t-lefeld/ONU-baja-daq/can/README.md

# CAN Bus

## Topology

- **Baud rate:** 500kbps
- **Physical layer:** Ethernet CAT5e twisted pair (differential pair used as CAN H/L)
- **Connectors:** Deutsch DT series throughout
- **Termination:** 120Ω at each end of the bus (firewall node and farthest corner node)

## Node IDs

| Node | CAN ID (base) | Location |
|---|---|---|
| Front | 0x010 | Toebox, frame-mounted |
| Rear | 0x020 | By the gas tank, frame-mounted |
| eCVT | 0x030 (reserved, unconfirmed) | CVT assembly |
| Firewall | 0x000 | Firewall — aggregator, **and carries GPS, IMU, LoRa and SD** |
| Display | not yet assigned | Driver-facing; listens only, never transmits |

The firewall is not sensorless: it reads GPS and a 9-DOF IMU directly. See
`nodes/firewall/README.md`.

eCVT is an ODrive S1 assembly rather than a custom sensor node (see
`nodes/ecvt/README.md`). It sits on this bus, but the DAQ side is paused
until next year. The ODrive addresses messages as
`(axis_node_id << 5) | cmd_id`, which collides with the DAQ's own block
unless the ODrive stays below node id 16 — see `protocol/V2_DESIGN_NOTES.md`.

## DBC File

**There is no `baja.dbc` in this folder.** Earlier revisions of this file
told you to load one; it does not exist. The real CAN databases are:

| File | Status |
|---|---|
| `protocol/telemetry.dbc` | **v1 — the wire format running today.** Generated by `tools/gen_dbc.py`, not hand-edited. |
| `protocol/telemetry_v2.dbc` | v2 scaffold — not on the wire yet. |

```python
import cantools
db = cantools.database.load_file('protocol/telemetry.dbc')
```

Treat the topology and wiring notes in this file as current, but take the
wire format itself from `protocol/`.

## Wiring Notes

- Ethernet twisted pair used for CAN H/L — do not use solid-core wire
- Deutsch DT connectors: pin A = CAN H, pin B = CAN L, pin C = GND reference
- Keep stub lengths short at each node tap — max 30cm recommended
- Shield drain wire tied to chassis GND at firewall end only (single-point ground)

## Reliability Features

- Sequence numbering on all messages — detect dropped frames at the dashboard
- Watchdog timer on each node — CAN TX halted and error frame sent if node hangs
- SD log on firewall captures raw CAN frames as backup regardless of LoRa link status
