t-lefeld/ONU-baja-daq/HANDOFF.md

# Handoff — read this first

Written 2026-08-12, updated 2026-08-23 for whoever (or whatever) picks this
up next. Assume no memory of prior conversations. This file is the
orientation; the other docs are the detail.

---

## What this is

A telemetry system for a **Baja SAE** competition vehicle, built by one
student (Tate, Ohio Northern University). Sensors on the car → CAN bus →
a hub board → 900 MHz LoRa radio → laptop in the pits, with an SD card on the
hub as a black box in case the radio drops.

**Hardware, all physically in hand and working:**

- 3× STM32F103C8 "Blue Pill" — CAN sensor nodes
- 1× STM32L476RG Nucleo — hub (aggregates CAN, drives radio + SD)
- 2× Ebyte E22-900T22 LoRa modules — one `-D` (DIP, on the hub), one `-U`
  (USB dongle, on the laptop). **Both configured to channel `0x45`
  (decimal 69) = 919.125 MHz.** Config mode: DIP module needs M1=HIGH/M0=LOW
  wiring; the USB dongle has a side button (hold ~2 s, LED goes solid red).
- microSD module on the hub over SPI
- Programming: a Black Magic Probe (a Black Pill flashed with BMP firmware)
  for the Bluepills over PlatformIO; the Nucleo uses its own onboard ST-Link.

**Planned but not yet wired:** HGLRC Mini M100 GPS, BNO080 IMU, 3× Littelfuse
55505-00-02-A-ND gear tooth sensors (two front wheels, one on the rear brake
disc), 4× AS5600 suspension encoders on bellcranks (one per corner, run in
analog-output mode), Anfield T200/T201 brake pressure, MLX90614 temperature,
ODrive S1 motor controller.

Part numbers above were corrected on 2026-10-30. Older docs may still say
NEO-M8N, Littelfuse 55075, or Bourns 53AAA pots — those are superseded. Note
the driver files `gps_neo_m8n.*` and `suspension_pot.*` keep their old names;
see `firmware/sensors/README.md` for why that's harmless.

---

## The single most important thing to understand

**There are three versions now: v1, v2, v3. v2 is fully bench-verified on
real hardware as of 2026-08-16 — end-to-end data flow, SD logging, and fault
recovery (node drop/reconnect, full bus drop/reconnect) all confirmed working.
v3 (real sensors) is in progress as of 2026-08-16 — CubeMX pin-out is done for
all three boards (Front, Rear, Hub), but no sensor driver has been wired into
`can_node_v2.c`/`telemetry_hub_v2.c` yet, and none of it has been physically
verified against real sensors. See `V3_BRINGUP_CHECKLIST.md` for exact status
per sensor.**

| | v1 | v2 | v3 |
|---|---|---|---|
| Status | **Working on real hardware**, verified end to end | **Fully bench-verified on real hardware** — live data, SD logging, fault recovery all confirmed | **In progress** — CubeMX pin-out done on all 3 boards; drivers not wired in, nothing physically verified yet |
| Channels | 9 placeholder | 24, but still **simulated in firmware**, not from real sensors | 24, real sensor reads (once driver wiring + verification catches up to the pin-out) |
| Nodes | 3 (all Bluepills) | 4 (Hub, Front, Rear, Motor — see board mapping below) | same as v2 |
| Frame | 42 bytes @ 2 Hz | 80 bytes @ 2 Hz | 80 bytes @ 2 Hz |
| What's flashed where | All 3 Bluepills + Hub | **2nd Bluepill = Front, 3rd Bluepill = Rear, Hub = Nucleo, 1st Bluepill = temporary Motor/E-CVT stand-in for the bench test.** | same boards as v2, minus the stand-in once the real ODrive replaces it |

**v3 CubeMX pin-out, done 2026-08-16 (see `V3_CUBEMX_AND_SENSOR_INTEGRATION_GUIDE.md`
for the canonical pinout and `V3_BRINGUP_CHECKLIST.md` for the per-sensor
checklist):** Front (2nd Bluepill) has wheel encoders on PA0/PA1 (EXTI,
falling edge, pull-up), suspension pots on PA4/PA5 (ADC1), and both brake
pressure transducers on PA6/PA7 (ADC1). Rear (3rd Bluepill) has the same
encoder/suspension pins plus the CVT thermistor on I2C1 PB6/PB7 — **this
assumes the PCB trace fix from PB8 to PB6 has actually been done; CubeMX
config and physical board traces are independent, so double check before
trusting this pin config.** Hub (Nucleo) has GPS on USART3 PC4/PC5 (9600
baud, RX interrupt) and the IMU on I2C1 PB8/PB9 + INT on PB1 (EXTI, falling
edge, pull-up) + RST on PB2 (GPIO output) — **these Hub pins are still
suggestions, no PCB has been shared for that board.** All three Bluepills'
ADC clocks were fixed to a valid 12MHz (PLLMUL stays X9 for 72MHz system
clock, ADC Prescaler set to /6 — never use CubeMX's "Resolve Clock Issues"
auto-solver here, it drops the whole system clock to fix the ADC alone, see
the mistake below). All 15 test suites pass after each board's regeneration.

**Board mapping for v2 (this was an open decision as of 08-12, settled 08-13,
then extended 08-14):** in the *final* design, node 0 (Hub/GPS/IMU) and node 3
(E-CVT/Motor) have no physical Bluepill — the hub originates both directly
(real GPS/IMU/ODrive in v3). Only Front and Rear are permanent Bluepill
roles.

**Temporary addition, 2026-08-14 — a 4th "board" for the v2 bench test only:**
the 1st Bluepill (previously the idle spare) is flashed with `node_id.h` set
to `NODE_ID 3` and now transmits real `tlm2_can_pack_pages()` bursts for the
Motor node, so the hub's reassembler gets exercised by an actual 4th CAN
transmitter instead of leaving node 3 hub-internal during the test. This is
**not** what node 3 looks like in the real system — the ODrive doesn't speak
this protocol at all, it speaks CAN Simple, addressed by `axis_node_id`, not
`TLM2_CAN_ID_FOR(3, page)`. Swapping in the real ODrive later means removing
this stand-in board from the bus entirely, not reflashing it to "the real
thing" — see `can_node_v2.h`'s header comment for the full reasoning. The
hub-side switch is `HUB2_SIMULATE_NODE3` in `telemetry_hub_v2.h`, set to `0`
via a compiler `-D` flag (both `platformio.ini`'s `build_flags` and the
CubeIDE `.cproject`'s preprocessor symbols — **not** a `#define` in `main.c`,
see the "translation unit" mistake below) right now specifically because this
stand-in is on the bus — **if you ever pull this board off the bus without
also flipping that back to `1` (or removing the `-D`), node 3 goes
stale/nothing shows up, not "back to simulated."** The 1st Bluepill is not a
working v1 fallback spare while wearing this hat — see the note in its
`node_id.h`.

**Two separate build systems, two separate exclusion lists — this bit us
2026-08-14.** Every project has both a CubeIDE `.cproject` and a
`platformio.ini`, and PlatformIO does **not** read `.cproject` at all — it
has its own `build_src_filter` that compiles everything under `Core/Src/` on
its own. Excluding a stale v1 file from one build system does nothing for
the other. Two exclusions were needed and are now both in place: the
Nucleo's `telemetry_hub.c` (duplicate `HAL_CAN_RxFifo0MsgPendingCallback` at
link time) and the 1st Bluepill's `can_node.c` (v1's `can_node.h` hard-errors
at compile time for `NODE_ID 3`, which is outside v1's valid 0-2 range, even
though nothing calls into that file). `tools/test_repo.py` now checks both
`platformio.ini` files for these exclusions specifically so this can't drift
back silently. **None of this has been compile-verified against the real ARM
toolchain from this end** — there's no `arm-none-eabi-gcc`/PlatformIO
available in the environment doing this work, only the host-side C tests
(hal_shim-mocked, not real HAL). The PlatformIO build output is the first
real compile check any of this has had — keep pasting errors if more show up.

**What "v2 wired in" actually means right now:** `can_node_v2.c`/`.h` and
`telemetry_hub_v2.c`/`.h` (all pre-existing, host-tested library code) are now
copied into the 2nd Bluepill, 3rd Bluepill, and Nucleo hub CubeIDE projects,
and each project's `main.c` calls the v2 init/task functions instead of v1's.
`telemetry_hub.c` is excluded from the hub project's build (both files define
a strong `HAL_CAN_RxFifo0MsgPendingCallback`, so linking both is a link
error). **None of this has been flashed to hardware or bench-tested yet** —
that's the next real milestone, and per the "verify, don't assert" rule nothing
above should be taken as proof it works until it's been run.

v1 files are untouched throughout — `protocol/telemetry_proto.{h,c}`,
`can_node.c`, `telemetry_hub.c`, and their mirrored copies in every project
are byte-identical to before. Reflashing any board back to v1 is always just
"go back to what main.c called before."

---

## Ground rules that have held all along

1. **Never modify the v1 files.** `protocol/telemetry_proto.{h,c}`, its four
   mirrored copies under `firmware/projects/*/Core/Src/`,
   `firmware/bluepill_node/can_node.c`, `firmware/nucleo_hub/telemetry_hub.c`.
   That is the known-good image Tate can always reflash to. v2 work goes in
   new files alongside.
2. **This repo has a `.git` directory but ZERO commits.** `git diff` is
   useless for checking what changed — everything is untracked. Verify
   "additive only" by mtime: `ls -l --time-style=+%m-%d_%H:%M`. v1 files
   should read Aug 1–4.
3. **Verify, don't assert.** Run the thing. Compile the thing. This has
   repeatedly caught errors that reading the code did not — see "mistakes
   already made" below.
4. **Tate does pins and calibration by hand.** He asked for clearly-labelled
   `TODO:` markers rather than guesses. Respect that.
5. **Do not generate `.ioc` files.** CubeMX silently drops keys it does not
   recognise, so a hand-edited one looks fine until a peripheral misbehaves.
   `firmware/PINOUT.md` says this loudly; keep it that way.

---

## Layout

```
protocol/     wire formats. telemetry_proto.* = v1 (live).
              telemetry_proto_v2.* = v2 (tested, unused). Both DBCs.
firmware/
  bluepill_node/   can_node.c (v1), can_node_v2.c (v2 — now wired into the
                   2nd/3rd Bluepill projects' main.c, not yet bench-tested)
  nucleo_hub/      telemetry_hub.c (v1), lora_e22.c, sd_log.c, sd_spi.c,
                   fat32.c, telemetry_hub_v2.c (v2 — now wired into the
                   Nucleo project's main.c, not yet bench-tested)
  sensors/         7 real-sensor drivers, all TODO-marked, none wired in
  control/         E-CVT PI controller + IMU hill feedforward, host-tested
  projects/        the 4 CubeIDE/PlatformIO projects (vendored HAL etc.)
pc_app/       Python ground station. run.py serves the browser dashboards.
              telemetry/proto.py = v1, proto_v2.py = v2, protocols.py picks.
simulation/   synthetic 24-channel feed + the dashboard app
field_data/   real SD captures go here. Empty on purpose (real data only).
tools/        15 test suites. run_all_tests.py runs everything.
```

**Docs worth reading before acting:** `PROJECT_STATUS.md` (what's left, by
track), `firmware/PINOUT.md` (pin audit + EXTI trap), `protocol/V2_DESIGN_NOTES.md`
(v2 rationale + open risks), `DATA_VERIFICATION_CHECKLIST.md` (how to tell
real sensor data from fake).

---

## Test suite

```
python tools/run_all_tests.py      # 15 suites, expect exit 0
```

**On Tate's Windows machine most C suites SKIP** — he has no host compiler
(STM32CubeIDE's targets ARM, not the host) and no `cantools`. His effective
coverage is roughly a third of what a Linux box with gcc gets. A green board
on his machine is honest but much quieter than it looks. `pip install
cantools` is the cheap win; the C tests need MSYS2/MinGW.

Convention: **a missing toolchain SKIPs and returns 0, never fails.** A suite
that goes red on a normal Windows box trains everyone to ignore red.

---

## Mistakes already made — do not repeat

- **A test that could only pass by not running.** `test_qt.py`'s Qt half
  skipped on Linux (no EGL), so it reported green for weeks. First time it
  actually ran, on Windows, it aborted the process via `qFatal` before a
  single assertion. It has been retired along with the native window.
- **Browser caching masqueraded as "the file didn't save."** Spent a round
  debugging code that wasn't the code running. `simulation/server.py` now
  sends `no-cache` on HTML/JS/CSS.
- **Windows exposed a real leak Linux hid.** `pump.py` dropped a failed CSV
  recorder without closing it. POSIX doesn't care; Windows can't delete an
  open file. Fixed — but the lesson is that platform-specific failures are
  often real bugs, not test noise.
- **"Identical by construction" was unenforced.** LoRa and SD getting the
  same bytes was true by reading the code, but SD was compiled *out* of the
  tests. `tools/test_paths_agree.py` now proves it, including a leg that
  confirms the check would actually fail if they diverged.
- **Three parallel subagents all died** (session limit / API error). One left
  `telemetry_hub_v2.c` unwritten. Run agents one at a time here.
- **A `#define` in one `.c` file is invisible to another's `#include` of the
  same header — obvious in hindsight, expensive on the bench.**
  `HUB2_SIMULATE_NODE3 0` was originally placed as a `#define` in the Nucleo
  project's `main.c`, right before `#include "telemetry_hub_v2.h"`, intending
  to override the header's `#ifndef` default (1). It compiled fine and looked
  correct on inspection. It did nothing. `main.c` and `telemetry_hub_v2.c` are
  separate translation units — each is preprocessed independently, so
  `telemetry_hub_v2.c`'s own `#include` of the same header never saw main.c's
  `#define`, and the `#if HUB2_SIMULATE_NODE3` check that actually matters
  (in `telemetry_hub_v2.c`) always evaluated the header's default instead.
  Burned an entire Stage 4 bench session: the E-CVT stand-in node never went
  stale no matter how many times the board was rebuilt, reflashed, or
  power-cycled, because the hub was still fabricating it locally the whole
  time. Fixed by moving the override to a compiler `-D` flag (visible to
  every translation unit) in both `platformio.ini` and the CubeIDE
  `.cproject`, and `tools/test_repo.py` now checks for the flag in both build
  files instead of the old (silently-wrong) main.c pattern. **General rule:
  a compile-time value one file needs to hand to another file's `#if` check
  belongs in a build flag, not a `#define` before an `#include`.**
- **A one-time boot-banner print is un-catchable by hand.** Tried to have
  Tate visually confirm a compiled-in macro value via a debug line that only
  printed once, immediately at power-on. A human physically unplugging,
  replugging, and reopening a serial monitor cannot win that race — the
  board reaches the print within milliseconds of power stabilizing. Moved the
  value onto the periodic (500ms) debug line instead, which is always on
  screen with no timing dependency. If a debug value needs eyeballing on real
  hardware, put it somewhere that repeats, not somewhere that fires once.
- **CubeMX's "Resolve Clock Issues" auto-solver fixes the one thing you
  flagged by breaking everything else.** Enabling ADC1 on the Bluepills
  (v3 pin-out, 2026-08-16) triggers an out-of-range warning because the
  default `/2` ADC prescaler gives 36MHz against a 14MHz hardware limit.
  Clicking "Yes" on the auto-solver's "run automatic clock issues solver?"
  prompt dropped `PLLMUL` from `X9` to `X2`, taking the whole system clock
  from 72MHz to 16MHz — which would have silently broken the CAN bit-timing
  (`CAN.Prescaler=9` was computed for 72MHz) along with every other
  peripheral's timing, not just fixed the ADC. Always click "No", then fix
  only the ADC Prescaler by hand (`/6` gives a valid 12MHz), leaving
  `PLLMUL` alone.
- **CubeMX doesn't always default I2C to the pin pair you'd expect, even
  when the "obvious" one is free.** On the Hub's L476 (unlike the
  F103 Bluepills, which have a strict PB6+PB7-or-PB8+PB9 remap pairing),
  SCL and SDA are independent per-pin alternate functions — SCL can be
  PA9/PB6/PB8, SDA can be PA10/PB7/PB9, and CubeMX will happily pick any
  valid combination, not necessarily the "matching numbered" one. Enabling
  I2C1 here auto-picked PB8 (SCL) + PB7 (SDA) even though PB9 was free and
  is what the docs specify — both are electrically valid, but PB7 is a
  silent mismatch against `V3_CUBEMX_AND_SENSOR_INTEGRATION_GUIDE.md`.
  Caught by checking the generated `.ioc` after generation, not by trusting
  the pinout diagram at a glance. Fixed by manually reassigning SDA to PB9.
  **General rule: after any auto-pin-assignment on a chip with independent
  (non-paired) alternate functions, grep the generated `.ioc` for the exact
  pins the docs specify — don't assume CubeMX picked the "obvious" one.**

---

## Known-unverified — flag these, don't trust them

- **ODrive `Get_Temperature` CAN command ID** (`firmware/sensors/odrive_can.c`)
  is an educated guess. The other three IDs are from the official reference.
  Check against `can_simple.dbc` in the ODrive firmware repo.
- **BNO080 Q-point scaling** (`imu_bno080.c`) is from the SH-2 manual, never
  run against hardware. Symptom of it being wrong: readings off by a clean
  power of 2.
- **LoRa throughput (~200 B/s)** came from a code comment and has never been
  measured. v2's 80-byte frame sits at ~80% link utilisation on that
  assumption. If the real number is lower, v2 does not fit at 2 Hz —
  fallbacks are ranked in `V2_DESIGN_NOTES.md`.
- **`brake_resistor_w`** is inferred from negative bus current, not measured.
  No such CAN message exists.

---

## Open decisions needing Tate, not code

1. ~~How node 3 (E-CVT/Motor) gets populated.~~ **Settled and implemented
   2026-08-14**: the hub originates nodes 0 and 3 itself (simulated for now),
   Front and Rear are the two real Bluepills, the 3rd (1st-numbered) Bluepill
   is the spare.
2. **ODrive `axis_node_id`** must not collide with the `0x200` block v2 uses
   for node pages. Still open — `HUB2_ODRIVE_AXIS_NODE_ID` defaults to 0 in
   `telemetry_hub_v2.h`; confirm against whatever you actually set on the
   ODrive with `odrivetool` before `HUB2_USE_REAL_ODRIVE` ever gets flipped on.
3. Whether to push to GitHub before or after the remaining cleanup — repo now
   has 4 commits locally (see below), still not pushed anywhere.

---

## A repo-corruption risk found and worked around, 2026-08-14

This repo lives inside OneDrive, and the "OneDrive syncing `.git` mid-op can
corrupt things" warning in `NEXT_STEPS.md` turned out to be real, just not in
the way expected: a sandboxed agent working on this repo could create git
lock files (`.git/index.lock`, `.git/HEAD.lock`, `.git/objects/*.lock`) but
**could not delete them afterward** — not a git problem, a general inability
to delete anything on this OneDrive mount from that environment. Every git
write left a stray lock behind that blocked the next one, and only Tate,
working locally, could clear it. One commit went through per "session" before
needing a manual unstick. If this happens again: close anything that might
hold a git handle (IDE, GitHub Desktop, a stray terminal), then delete the
`*.lock` files under `.git/` by hand. This is a good argument for finishing
the move off OneDrive (see NEXT_STEPS.md's "About OneDrive" section) sooner
rather than later.

## Immediate next steps, in order

1. **Push to GitHub.** 15 commits exist locally; still nothing pushed, so
   every bit of this is one disk failure from gone. Highest value per minute
   on this list by a wide margin. `.gitignore` already excludes
   `pc_app/.browser-profile/` — verify with
   `git ls-files --cached | findstr browser-profile` → must print nothing —
   before pushing.
2. **Measure real LoRa throughput.** The last remaining unverified assumption
   from the v2 design: everything about the 80-byte frame fitting at 2 Hz
   rests on a ~200 B/s figure that came from a code comment and has never
   been measured. Now cheap to do, since `--vcp` gives a wired reference feed
   to compare the radio against. See `protocol/V2_DESIGN_NOTES.md` for the
   ranked fallbacks if the real number comes in lower.
3. **Start v3 sensor wiring.** CubeMX pin-out is done on all three boards, so
   the next step is code: wire real sensors into `can_node_v2.c`'s
   `sim_read_channels()` and `telemetry_hub_v2.c`'s `hub2_originate_node0/3()`
   one at a time, per `firmware/NODE_INTEGRATION_V2.md`. Do them singly and
   verify each against the real sensor before moving on —
   `V3_BRINGUP_CHECKLIST.md` tracks per-sensor status.
4. **Fix `imu_bno080.h` before turning on `HUB2_USE_REAL_IMU`.** That header
   hardcodes `#include "stm32f1xx_hal.h"` (a Bluepill HAL), which does not
   exist on the L476RG hub and will not compile there. Swap it to
   `stm32l4xx_hal.h`. Known and deliberately left alone rather than patched
   blind; it blocks the IMU half of node 0.
5. **Confirm the ODrive `Get_Temperature` command ID** against `can_simple.dbc`
   in the ODrive firmware repo before trusting `motor_temp` — it is the one
   ODrive command ID in `firmware/sensors/odrive_can.c` that was a guess
   rather than taken from the official protocol reference.
6. Tate offered to send schematics for a wiring audit against `PINOUT.md`.

---

## Working with Tate

Prefers concise, direct answers. Moves fast, often changes direction
mid-thread (four dashboards → one tabbed app; keep the native window →
retire it) — follow the new direction, don't relitigate.

He is doing real hardware work with real failure modes, so **precision
matters more than reassurance**. He has been well served by being told
plainly when something is unverified, and poorly served by confident claims
that turned out to rest on untested code. When something is a guess, say so.

He is not a professional software engineer — explain *why* a thing matters,
not just what to type.

---

## UI swap, 2026-08-16

`pc_app/static/index.html` (the real-hardware dashboard) was replaced with a
"Pit Wall" themed design (dark instrument panels, amber readouts, 7 tabs)
built in a separate session and uploaded here. It plugs into the exact same
`telemetry-core.js` backend contract, so no protocol changes were needed, but
three real gaps had to be closed before it actually worked:

1. It fetched Google Fonts over the network — removed. This dashboard has to
   work in a pit lane with no wifi, same as everything else in `pc_app/`.
   `tools/test_repo.py` already enforced "no external http(s) resources" from
   the old design; it caught this immediately.
2. Its "Logs" tab called `/api/logs`, which only ever existed on the
   simulator's server (`simulation/server.py`) — ported into the real
   `telemetry/server.py` too.
3. Its "WIRE" header chip reads `frame_bytes`/`wire_format` off the
   meta/status WebSocket messages, which `pump.py` never sent — added there.

Also replaced a hardcoded "SYNTHETIC FEED — NOT LIVE HARDWARE" footer (copied
from the simulator's copy of this same design, where it's always true) with
one that reads the real source off `meta.source` — that label would have been
actively wrong the moment real CAN data started flowing through it.
