t-lefeld/ONU-baja-daq/docs/build-log/README.md

# Build Log

Dated entries documenting architecture decisions, component selections, and milestones.

## Entries

| # | Entry | Topic |
|---|---|---|
| 01 | [CAN Bus Architecture](01_can_bus_architecture.md) | 500kbps, Ethernet twisted pair, DT connectors |
| 02 | [LoRa Telemetry Architecture](02_lora_telemetry.md) | 915MHz, freq hopping, SQLite — receiver/frontend since superseded by 04 and 05 |
| 03 | [Node Platform Selection](03_node_platform.md) | STM32 Blue Pill nodes, Nucleo L476RG firewall — eCVT since superseded by 05 |
| 04 | [Pit Dashboard: Browser-Based Instead of PyQtGraph](04_web_dashboard_pivot.md) | Web Serial API dashboard replaces Flask/FastAPI + PyQtGraph frontend |
| 05 | [Receiver Hardware Correction, eCVT Clarification, Steering Wheel Descope](05_receiver_and_scope_corrections.md) | ESP32 → E22-900T22U, eCVT → ODrive S1 assembly, steering wheel node removed |

---

## Template

```markdown
# NN — Title

**Date:** YYYY-MM  
**Type:** [Design decision | Component selection | Testing results | Architecture change | Milestone | Failure analysis]

## Overview

## [Context / Requirements / What happened]

## [Decision / Analysis]

## Key Takeaways

-
-
```
