t-lefeld/ONU-baja-daq/firmware/projects/2nd Bluepill/2nd Bluepill.ioc

Mcu.UserName=STM32F103C8Tx
PA0-WKUP.Signal=GPXTI0
PA1.Signal=GPXTI1
PA11.Signal=CAN_RX
PA12.Signal=CAN_TX
PA13.Signal=SYS_JTMS-SWDIO
PA14.Signal=SYS_JTCK-SWCLK
PA4.Signal=ADCx_IN4
PA5.Signal=ADCx_IN5
PA6.Signal=ADCx_IN6
PA7.Signal=ADCx_IN7
PD0-OSC_IN.Signal=RCC_OSC_IN
PD1-OSC_OUT.Signal=RCC_OSC_OUT
