t-lefeld/ONU-baja-daq/firmware/projects/Nucleo CAN Bus Test/Core/Src/main.c

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
/* Includes ------------------------------------------------------------------*/
#include "main.h"

/* USER CODE BEGIN Includes */
/* v2 bench test, 2026-08-14: the 1st Bluepill is temporarily standing in for
   node 3 (E-CVT/Motor) on the real CAN bus (node_id.h there is set to 3), so
   the hub must NOT also fabricate node 3 locally - see HUB2_SIMULATE_NODE3's
   comment in telemetry_hub_v2.h.
   NOTE, 2026-08-16: a #define here does NOT work - this file and
   telemetry_hub_v2.c are separate translation units, and the #if that
   matters is evaluated in telemetry_hub_v2.c's own independent preprocessing
   of this same header, which never sees a #define placed here. The actual
   override lives in platformio.ini's build_flags (-D HUB2_SIMULATE_NODE3=0)
   and the CubeIDE project's Preprocessor settings - see HUB2_SIMULATE_NODE3's
   comment in telemetry_hub_v2.h for the full explanation. Set back to 1 (or
   remove the -D) once the stand-in board is off the bus and nothing real has
   replaced it. */
#include "telemetry_hub_v2.h"
/* USER CODE END Includes */

CAN_HandleTypeDef hcan1;

I2C_HandleTypeDef hi2c1;

UART_HandleTypeDef huart1;
UART_HandleTypeDef huart2;
UART_HandleTypeDef huart3;
DMA_HandleTypeDef hdma_usart1_tx;

void SystemClock_Config(void);
static void MX_GPIO_Init(void);
static void MX_DMA_Init(void);
static void MX_CAN1_Init(void);
static void MX_USART2_UART_Init(void);
static void MX_USART1_UART_Init(void);
static void MX_I2C1_Init(void);
static void MX_USART3_UART_Init(void);
/**
  * @brief  The application entry point.
  * @retval int
  */
int main(void)
{

  /* MCU Configuration--------------------------------------------------------*/

  /* Reset of all peripherals, Initializes the Flash interface and the Systick. */
  HAL_Init();

  /* Configure the system clock */
  SystemClock_Config();

  /* Initialize all configured peripherals */
  MX_GPIO_Init();
  MX_DMA_Init();
  MX_CAN1_Init();
  MX_USART2_UART_Init();
  MX_USART1_UART_Init();
  MX_I2C1_Init();
  MX_USART3_UART_Init();
  /* USER CODE BEGIN 2 */

  /* huart1 -> E22 LoRa module, huart2 -> ST-Link virtual COM port */
  hub2_init(&hcan1, &huart1, &huart2);

  /* USER CODE END 2 */

  /* Infinite loop */
  /* USER CODE BEGIN WHILE */
  while (1)
  {
    /* USER CODE END WHILE */

    /* USER CODE BEGIN 3 */
    hub2_task();
  }
  /* USER CODE END 3 */
}

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
