t-lefeld/ONU-baja-daq/tools/test_qt.py

#!/usr/bin/env python3
"""
FramePump and native-window tests.

    python tools/test_qt.py

Two halves:

  FramePump   - pure logic, no GUI toolkit involved. This is the code both
                the native window and the (opt-in) browser dashboard share,
                so it is tested once here independently of either front end.

  qt_app      - builds the actual PySide6 MainWindow headlessly
                (QT_QPA_PLATFORM=offscreen) and drives it through both a
                direct signal-handler call and a real worker thread with a
                real asyncio loop, to prove the cross-thread signal bridge
                actually delivers frames rather than just type-checking.

Skips the qt_app half cleanly if PySide6 is not importable, or if the
offscreen platform plugin cannot load (this happens in minimal Linux
environments missing system Mesa/EGL libraries; PySide6's Windows wheels
bundle everything they need, so this is a test-environment limitation, not
an application bug). The FramePump half always runs, since it has no such
dependency.
"""

from __future__ import annotations

import asyncio
import os
import sys
import tempfile
import time
from pathlib import Path

ROOT = Path(__file__).resolve().parent.parent
sys.path.insert(0, str(ROOT / "pc_app"))

from telemetry import proto  # noqa: E402
from telemetry.pump import FramePump  # noqa: E402
from telemetry.recorder import CsvRecorder  # noqa: E402
from telemetry.sources import FrameSource, SimulatorSource  # noqa: E402

failures: list[str] = []
checks = 0


def check(label: str, got, want) -> None:
    global checks
    checks += 1
    if got != want:
        failures.append(f"{label}\n     got  {got!r}\n     want {want!r}")


def ok(label: str, cond: bool) -> None:
    global checks
    checks += 1
    if not cond:
        failures.append(label)


# ====================================================================
# FramePump: meta / status shape
# ====================================================================


def test_pump_meta_and_status() -> None:
    print("-- pump: meta() and status() shape")

    pump = FramePump(SimulatorSource())

    meta = pump.meta()
    check("meta type", meta["type"], "meta")
    check("meta source", meta["source"], "simulator")
    check("meta node count", meta["node_count"], proto.NODE_COUNT)
    check("meta lists every node", len(meta["nodes"]), proto.NODE_COUNT)
    check("meta first node's channel count", len(meta["nodes"][0]["channels"]), proto.CH_PER_NODE)

    status = pump.status()
    check("status type", status["type"], "status")
    check("no frames seen yet", status["frames"], 0)
    ok("no error yet", status["error"] is None)
    ok("last_frame_age_s is None before any frame", status["last_frame_age_s"] is None)

    extra_status = pump.status({"clients": 3})
    check("status() merges extra fields", extra_status["clients"], 3)


# ====================================================================
# FramePump: consuming frames, recording, stats
# ====================================================================


def test_pump_run_records_and_tracks_stats() -> None:
    print("-- pump: run() consumes frames, records CSV, updates stats")

    with tempfile.TemporaryDirectory() as td:
        csv_path = Path(td) / "out.csv"
        recorder = CsvRecorder(csv_path)
        pump = FramePump(SimulatorSource(), recorder)

        received: list[dict] = []

        async def scenario():
            task = asyncio.create_task(pump.run(received.append))
            # The simulator ticks at FRAME_PERIOD_MS; wait for a few frames.
            await asyncio.sleep(proto.FRAME_PERIOD_MS / 1000.0 * 3.5)
            task.cancel()
            try:
                await task
            except asyncio.CancelledError:
                pass
            await pump.close()

        asyncio.run(scenario())

        ok("received at least 3 frames in 3.5 periods", len(received) >= 3)
        check("stats.frames_seen matches callback count", pump.stats.frames_seen, len(received))
        ok("last_frame_at was stamped", pump.stats.last_frame_at is not None)
        ok("no pump_error on a clean run", pump.stats.pump_error is None)

        payload = received[0]
        ok("frame payload carries host_epoch", "host_epoch" in payload)
        check("frame payload node count", len(payload["nodes"]), proto.NODE_COUNT)

        status = pump.status()
        check("status reflects csv path", status["csv"], str(csv_path))
        check("status csv_rows matches frames recorded", status["csv_rows"], len(received))

        ok("CSV file actually has rows", csv_path.read_text().count("\n") >= len(received))


def test_pump_status_loop() -> None:
    print("-- pump: status_loop() fires on its own timer")

    pump = FramePump(SimulatorSource())
    ticks: list[dict] = []

    async def scenario():
        task = asyncio.create_task(pump.status_loop(ticks.append, interval=0.05))
        await asyncio.sleep(0.23)
        task.cancel()
        try:
            await task
        except asyncio.CancelledError:
            pass

    asyncio.run(scenario())

    ok("status_loop fired multiple times independent of frame arrivals",
       len(ticks) >= 3)
    ok("every tick is a status message", all(t["type"] == "status" for t in ticks))


# ====================================================================
# FramePump: error handling
# ====================================================================


class _ExplodingSource(FrameSource):
    """A source whose frames() raises - the 'something genuinely
    unexpected happened' case run() is supposed to catch and record rather
    than propagate. Recoverable failures (unplugged USB, etc.) are the
    source's own job to absorb; this exercises the pump's last-resort net."""

    name = "exploding"
    link_state = "n/a"
    detail = ""

    async def frames(self):
        raise RuntimeError("simulated hardware fire")
        yield  # pragma: no cover - makes this an async generator
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
