t-lefeld/ONU-baja-daq/(commit log)

2026-07-23 Add browser-based pit telemetry dashboard and FastAPI/SQLite logging backend
    - telemetry/dashboard/baja_telemetry_dashboard.html: single-file, fully
    offline live dashboard (Web Serial), gauges/alarms/charts/GPS trail/lap
    timer/CSV export, fully config-driven sensor list
    - telemetry/dashboard/backend/: FastAPI + SQLite persistent logging service
    with configurable storage path, session rotation, and read-back endpoints
    (14 passing tests)
    - Pivoted pit dashboard frontend from planned PyQtGraph to browser-based;
    see docs/build-log/04_web_dashboard_pivot.md for rationale
    - Updated root README and telemetry/dashboard/README.md to match
2026-07-23 Wire dashboard to FastAPI backend for persistent logging
    - Add CORS middleware to backend/app/main.py so browser fetch() calls
    from the dashboard (any origin/file://) aren't blocked. Verified with
    curl against a live server: access-control-allow-origin header now
    present; full backend pytest suite (14 tests) still passes.
    - Add backend integration to baja_telemetry_dashboard.html: Session tab
    gets a 'Server Logging' panel (URL input, connect/disconnect toggle,
    status pill). On connect, the dashboard health-checks the backend,
    starts a session, and forwards every parsed telemetry packet via
    POST /telemetry alongside the existing local CSV log. 'New Run'
    cycles the backend sess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
2026-07-23 Correct receiver hardware, remove steering wheel node, sync node docs
    - ESP32 pit receiver -> E22-900T22U USB LoRa dongle (no onboard MCU),
    correcting root README, docs/architecture.md, telemetry/lora/README.md,
    telemetry/dashboard/README.md, and backend docs/comments. Historical
    build-log entries (02, 03) left intact but flagged superseded rather
    than rewritten.
    - Removed the steering wheel / Nextion driver display node entirely
    (diagram, structure tree, build status) - no longer part of the plan.
    - Synced node docs to actual PCB/enclosure design decisions: Front and
    Rear now list their real sensors (Littelfuse 55075 wheel hub encoders,
    Bourns bellcrank pots, Anfield pressure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
2026-08-13 Initial baseline: verified v1 firmware, ground station, test suites, and v2 protocol library
2026-08-13 feat(hub): implement telemetry_hub_v2.c multi-frame CAN aggregator
2026-08-13 feat(v3): make sensor headers portable and add CubeMX pinout integration guide
2026-08-15 feat(v2): wire can_node_v2/telemetry_hub_v2 into real projects; 1st Bluepill stands in for Motor node in bench test
2026-08-16 fix(v2): motor-node stand-in on 1st Bluepill, platformio.ini build-src-filter fixes
    [can_node_v2.c, test_repo.py]
2026-08-17 feat(v3): CubeMX pin-out for Front/Rear/Hub, delete retired 4th Bluepill
    v3 sensor bring-up, pin-out stage:
    - Front (2nd Bluepill): wheel encoders PA0/PA1 (EXTI, falling, pull-up),
    suspension pots PA4/PA5 (ADC1), brake pressure PA6/PA7 (ADC1, primary +
    redundant)
    - Rear (3rd Bluepill): same encoder/suspension pins, CVT thermistor on I2C1
    PB6/PB7 (assumes the PCB SCL trace fix from PB8 is done - unverified from
    here)
    - Hub (Nucleo): GPS on USART3 PC4/PC5 (9600 baud, RX interrupt), IMU on I2C1
    PB8/PB9 + INT on PB1 (EXTI, falling, pull-up) + RST on PB2 (GPIO output) -
    pins are still suggestions, no Hub PCB shared yet
    - Fixed ADC clock on all three Bluepills to a valid 12MHz (ADC pre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
    [2nd Bluepill.ioc, 3rd Bluepill.ioc, Nucleo CAN Bus Test.ioc, main.c, main.h, node_id.h]
2026-08-23 Add log cleanup, v2 simulator, and two wired live-data sources
    Ground station (pc_app/)
    ------------------------
    telemetry/cleanup.py, new. Prunes the app's own rotating session logs
    in paths.logs_dir(). Exposed as --list-logs / --clean-logs / --keep /
    --older-than / --dry-run, and as a "Ground station logs" panel in the
    dashboard with a preview-then-confirm flow.
    Safety rules, since a bug here loses data silently rather than loudly:
    only regular files matching LOG_PATTERNS directly inside logs_dir are
    ever eligible; symlinks are refused rather than followed; a resolved
    path outside logs_dir is refused; no filter means delete nothing; and
    --keep is a floor, so `--keep 10 --older-than 30` ca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
    [can_adapter.py, cleanup.py, server.py, sources.py, telemetry_hub.c, telemetry_hub.h, telemetry_hub_v2.c]
2026-08-24 Default --proto to v2
    v1 was the default for as long as it was the only format any board was
    flashed with. That stopped being true when Front/Rear/Hub were cut over
    to v2, but the default never moved, so a double-clicked Telemetry.exe
    decoded a v2 stream with a v1 decoder.
    That failure is quiet, which is what makes it worth fixing rather than
    documenting: you get a dashboard of plausible-looking wrong numbers, no
    error. Hit exactly this today - a no-flag launch logged "42 bytes" and
    showed v1 channels, and it read as the exe being stale rather than as a
    protocol mismatch.
    Also:
    - --proto help text claimed no firmware emits v2 and that --sim was
    v1-only. Both were true when written, neith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
2026-08-24 Bundle the dashboards into the exe; correct stale docs
    The 4 alternate dashboard designs have never worked in a built exe.
    telemetry.spec didn't ship simulation/dashboards/, and server.py found
    it by walking ../../.. from its own file, which only resolves in a
    source checkout. Every build ever shipped 404'd on /dashboards/.
    It stayed hidden because the failure is soft by design: server.py logs
    "not found - only relevant in dev checkouts" and carries on serving the
    main view, so a broken build looks like a working one. Fixed by adding
    it to the spec's datas and resolving the path through
    paths.resource_dir() when frozen - the same helper static_dir() already
    used. build.bat now curls /dashbo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
    [server.py, test_repo.py]
2026-10-30 Rewrite README: correct hardware facts, add navigation for new members
    The README's hardware details had drifted from the car. Corrected against
    the current build:
    - Five nodes (firewall, front, rear, eCVT, display), each documented
    separately with location and sensors
    - AS5600 bellcrank encoders, not Bourns pots
    - Littelfuse 55505-00-02-A-ND gear tooth sensors, not 55075
    - HCLRC M100 GPS, not u-blox NEO-M8N
    - Brake pressure read at the front master cylinders, covering both
    circuits; brake light stays independent of the DAQ board
    - Shock nitrogen pressure transducers marked testing-only
    - Added the MAX7219 display node and the DeWalt 20V power architecture,
    neither of which was docume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
2026-10-30 Reconcile all docs with the car's actual hardware
    Corrects every document against the hardware as confirmed 2026-10-30.
    Where the repo's two halves disagreed, nodes/ was usually the accurate
    one; firmware/ and simulation/ carried the older parts list.
    Part corrections, applied repo-wide:
    - Littelfuse 55075 -> 55505-00-02-A-ND (flange-mount geartooth)
    - Bourns 53AAA-B28-B15L pot -> AS5600 Hall-effect encoder
    - u-blox NEO-M8N -> HGLRC Mini M100
    - E32-900T30D -> E22-900T22D (already correct in lora_e22.c)
    Sensor counts, previously inconsistent between nodes/ and firmware/:
    - 4 suspension encoders, one per corner (2 per corner node)
    - 3 gear tooth sensors: one per front wheel, plus ONE at the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
2026-10-30 Fix unverified M100 baud claim; note GPS brand and chipset
    The previous commit's repo-wide rename turned "9600 baud per the NEO-M8N's
    power-on default" into the same sentence about the M100 in two files. That
    converted an inherited figure into a confident claim about a part nobody
    checked. Both now say the number came from the M8N and is unverified for
    the M100, and must be confirmed at bring-up.
    Also recorded that the module's brand is HGLRC (HCLRC is a common letter
    transposition that finds no vendor), and that the M100 is built on a
    10th-generation u-blox chip — which is why earlier docs here referred to a
    u-blox part, and why the existing NMEA parser carries over.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
