t-lefeld/ONU-baja-daq/(notices)

Notices in the files:
firmware/projects/Nucleo CAN Bus Test/Core/Inc/main.h:
Copyright (c) 2026 STMicroelectronics.
All rights reserved.
This software is licensed under terms that can be found in the LICENSE file
